phorton1/Arduino-CoilWindingMachine/docs/fusion/dxf/lock_piece.dxf

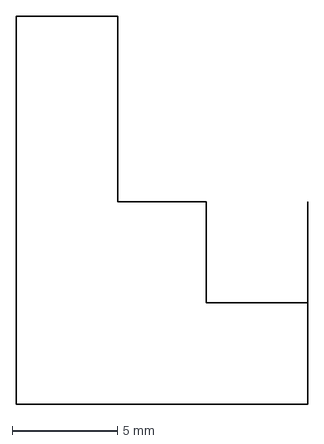
[picture p7: CAD file, 2023-06-16]
docs/fusion/dxf/lock_piece.dxf
13.8 x 18.4 mm
