phorton1/Arduino-CoilWindingMachine/docs/fusion/dxf/motor_face.dxf

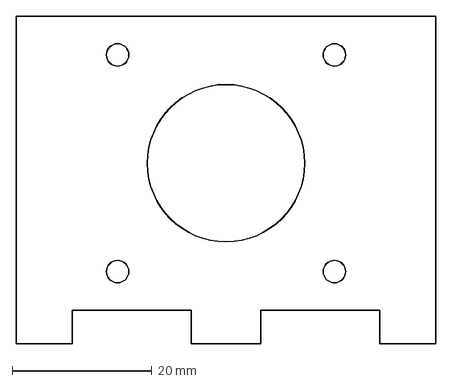
[picture p8: CAD file, 2023-06-16]
docs/fusion/dxf/motor_face.dxf
60.0 x 46.8 mm
