phorton1/Arduino-CoilWindingMachine/docs/fusion/dxf/base.dxf

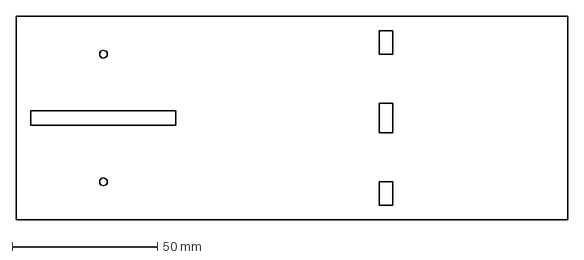
[picture p9: CAD file, 2023-06-16]
docs/fusion/dxf/base.dxf
190.0 x 70.0 mm
