phorton1/Arduino-CoilWindingMachine/docs/fusion/dxf/slider_face.dxf

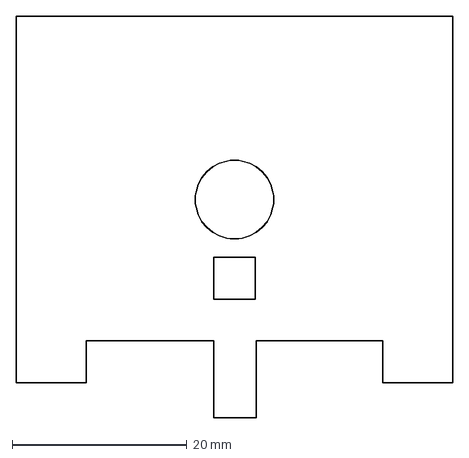
[picture p10: CAD file, 2023-06-16]
docs/fusion/dxf/slider_face.dxf
50.0 x 46.0 mm
