phorton1/Arduino-CoilWindingMachine/docs/fusion/dxf/slider_base.dxf

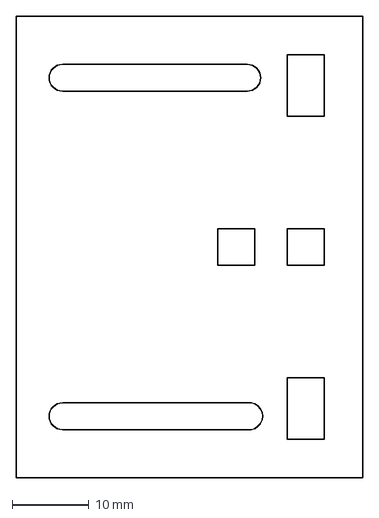
[picture p11: CAD file, 2023-06-16]
docs/fusion/dxf/slider_base.dxf
45.0 x 60.0 mm
