phorton1/Arduino-CoilWindingMachine/(list of files, cad)

Other CAD files:
docs/fusion/CoilWindingMachine.f3d
